xouillet/appleii/docs/ROM9316.pdf

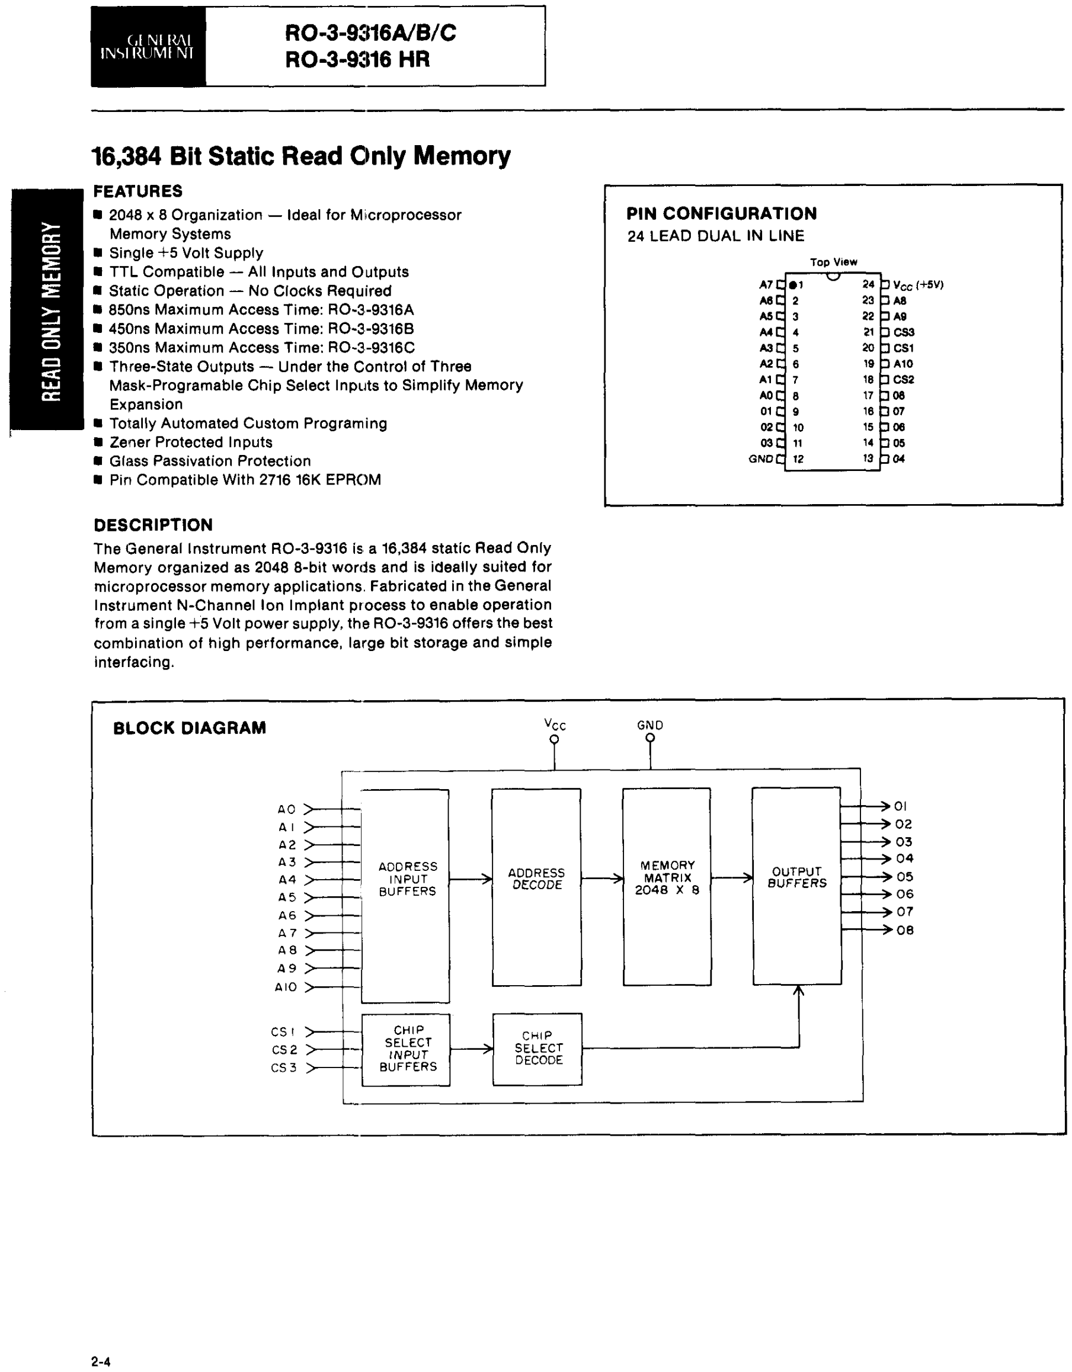
[picture p14: page 1]
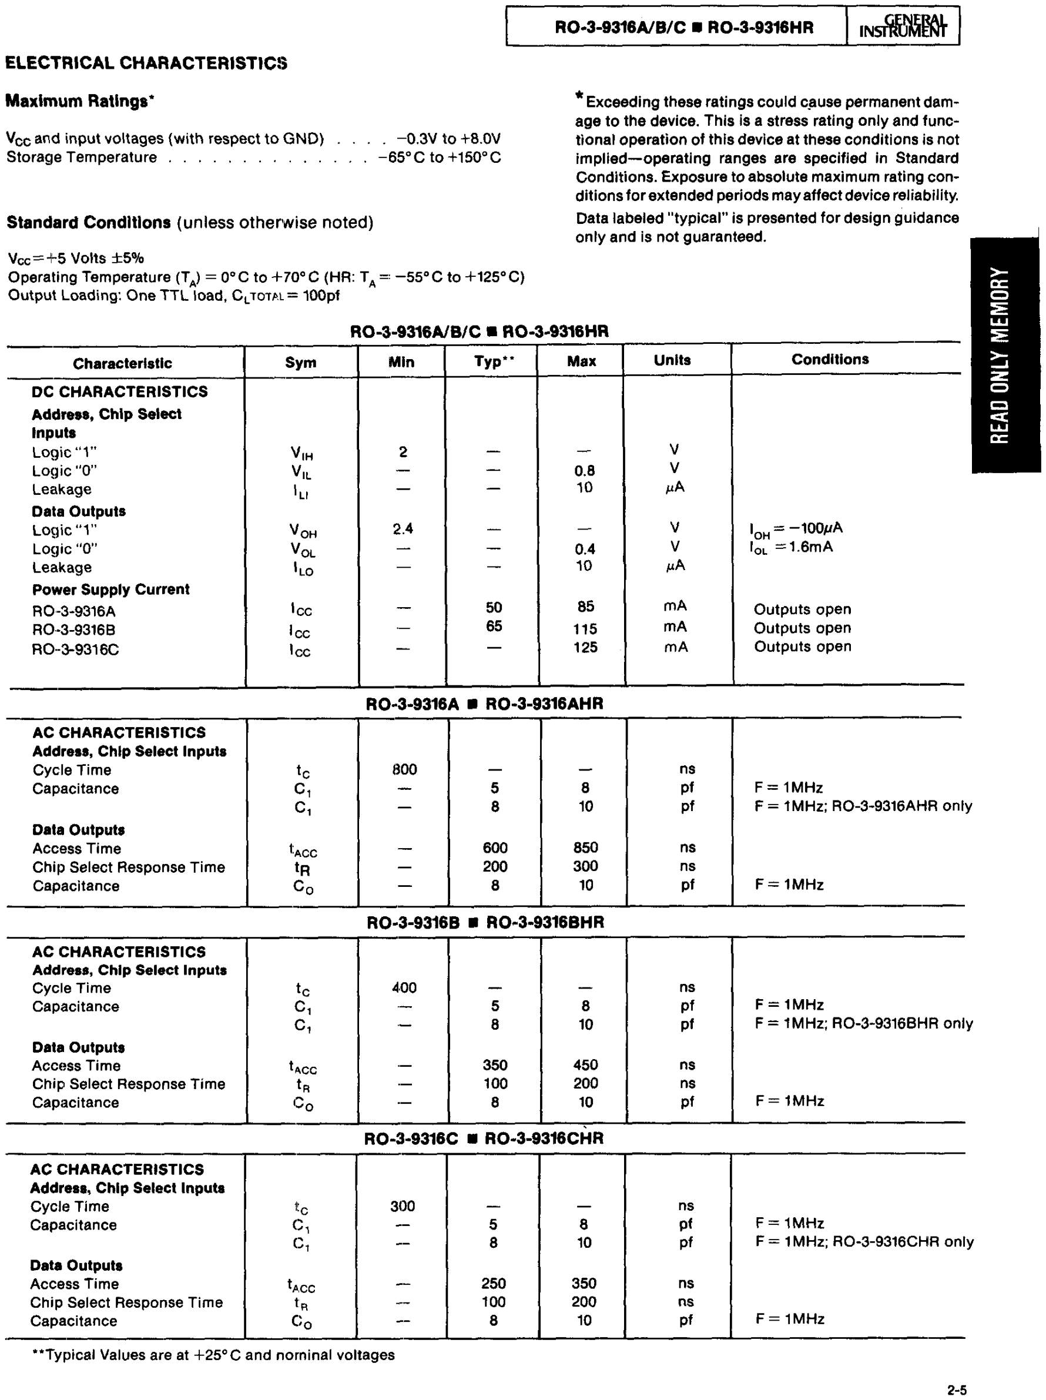
[picture p15: page 2]
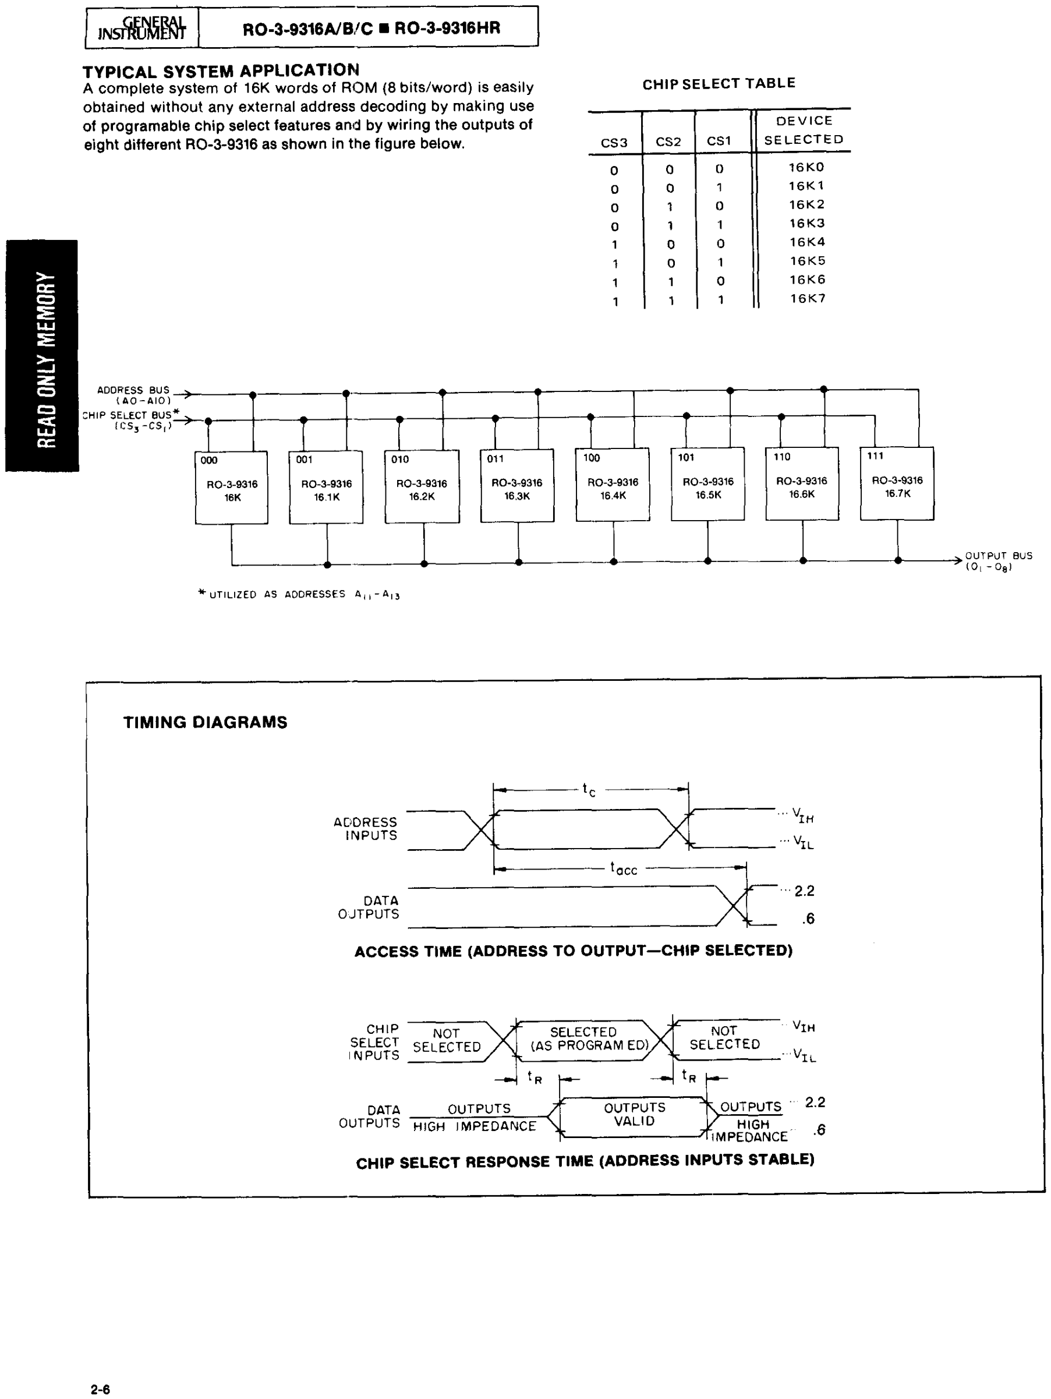
[picture p16: page 3]
